ECE3400Team19/ECE3400Team19.github.io/index.md

# ECE 3400 Fall 2018 - Team 19

[Contract](Contract/contract.md)
||
[Lab 1](Lab1/lab1.md)
||
[Milestone 1](Milestone1/milestone1.md)
||
[Lab 2](Lab2/lab2.md)
||
[Milestone 2](Milestone2/milestone2.md)
||
[Lab 3](Lab3/lab3.md)
||
[Lab 4](Lab4/lab4.md)
||
[Milestone 3](Milestone3/milestone3.md)
||
[Milestone 4](Milestone4/milestone4.md)

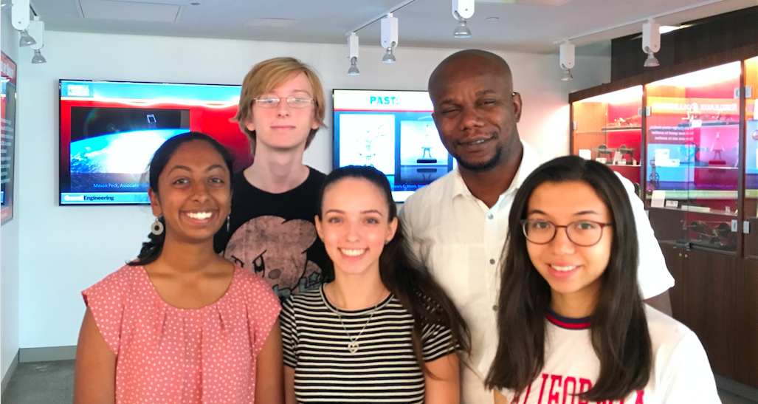
[picture p1: Team 19.png]
banner
## Team Members: 
* Asena Ulug          
* Cynthia Zelga
* John Chukwunonso Nwankwo
* Robert Morgowicz
* Laasya Renganathan
