ECE3400Team19/ECE3400Team19.github.io/Milestone4/milestone4.md

# Milestone 4: Treasure Detection
[Home](https://ece3400team19.github.io/)

## Milestone Description

Milestone 4 requires our robot to be able to:
  * detect when there are/are not treasures
  * successfully distinguish between red and blue treasures
  * successfully distinguish a square, triangle, and diamond shape

## Milestone Materials

This milestone was an extension of Lab 4 and utilized the same materials:
* OV7670 camera
* Altera DE0 Nano FPGA
* Arduino Uno

##
