ECE3400Team19/ECE3400Team19.github.io/6_Fotor.jpg

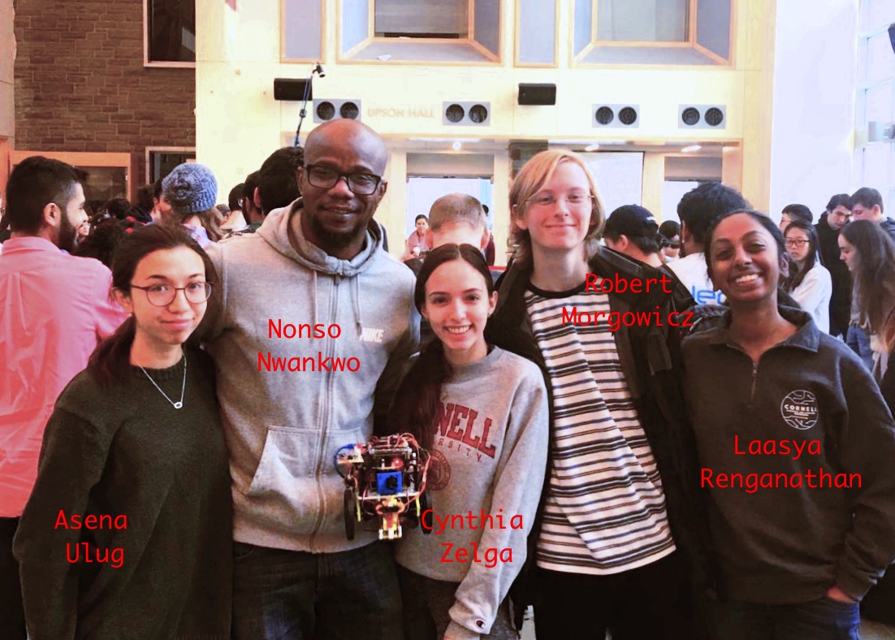
6_Fotor.jpg
