ECE3400Team19/ECE3400Team19.github.io/19-K.jpg

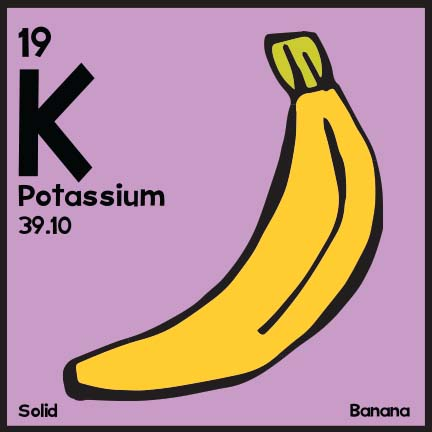
19-K.jpg
