ECE3400Team19/ECE3400Team19.github.io/arduino.JPG

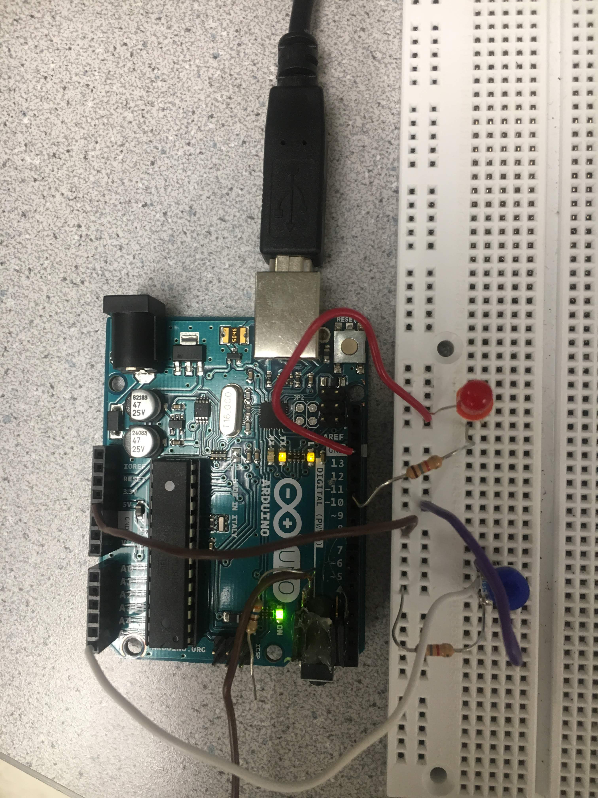
arduino.JPG
