ECE3400Team19/ECE3400Team19.github.io/Asena.png

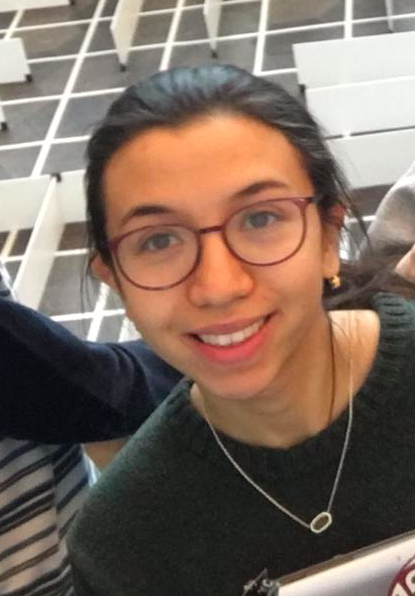
Asena.png
