ECE3400Team19/ECE3400Team19.github.io/camera-mount.jpg

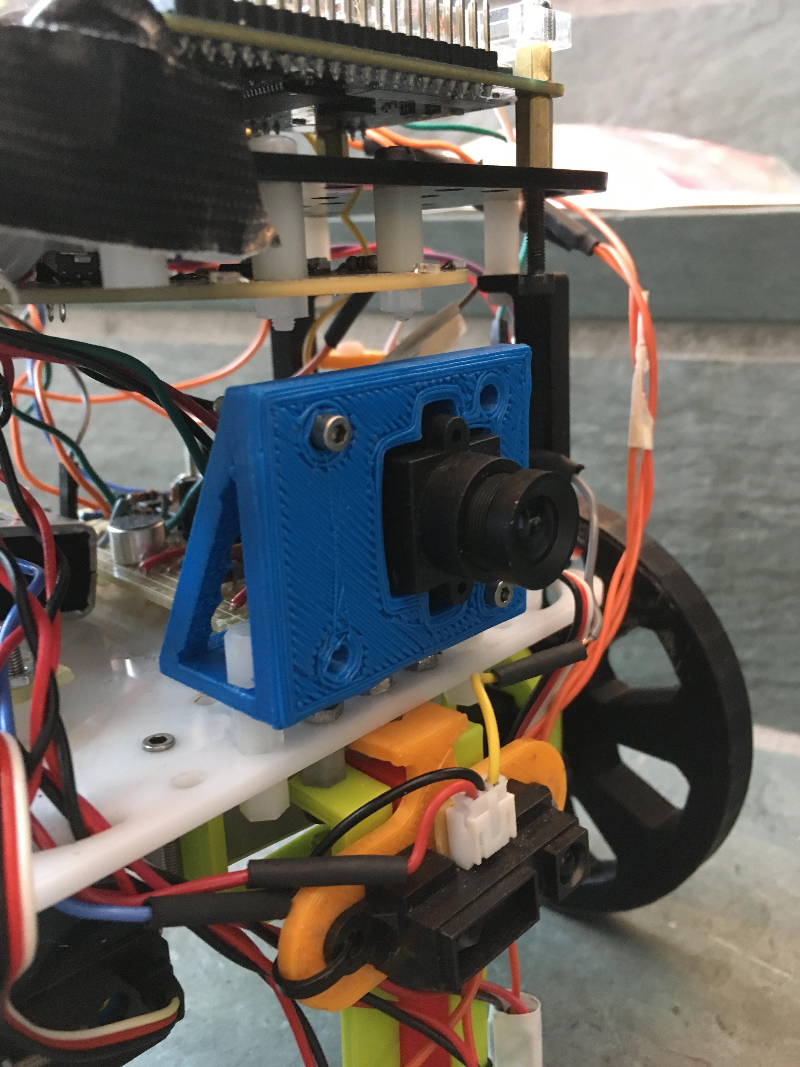
camera-mount.jpg
