ECE3400Team19/ECE3400Team19.github.io/Cynthia.png

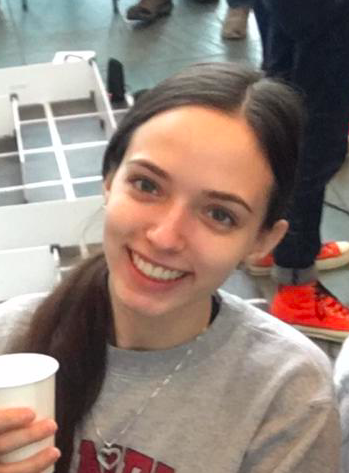
Cynthia.png
