ECE3400Team19/ECE3400Team19.github.io/Design.jpg

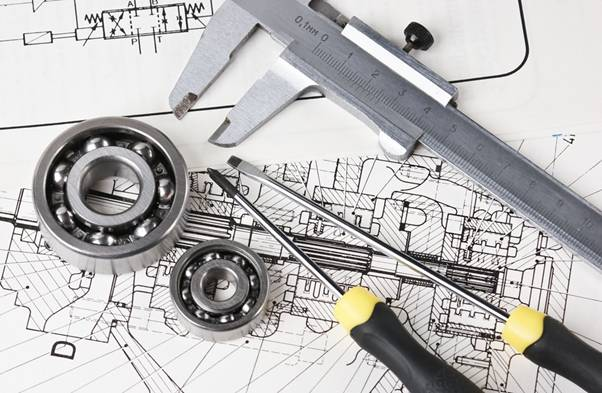
Design.jpg
