ECE3400Team19/ECE3400Team19.github.io/ethics.png

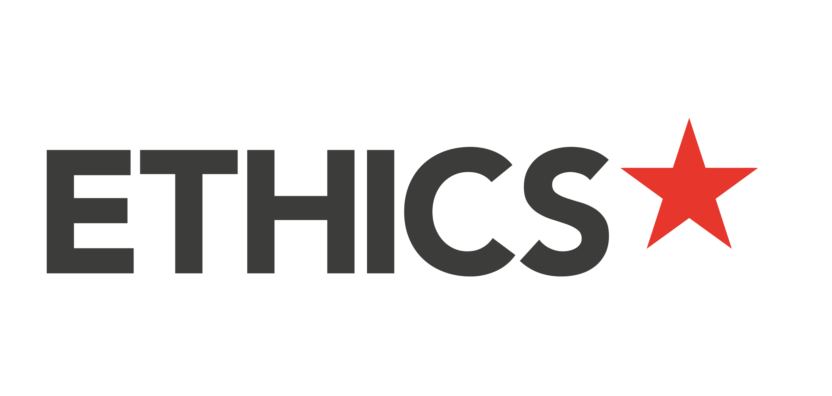
ethics.png
