ECE3400Team19/ECE3400Team19.github.io/Final_Des_FSM_Color.png

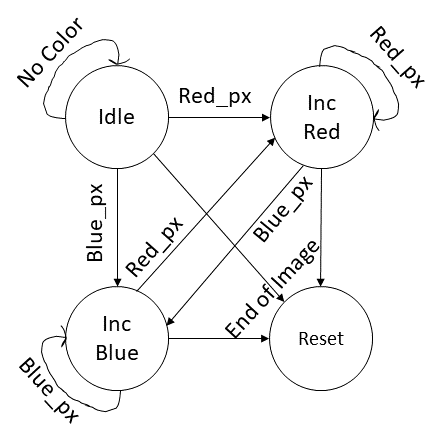
Final_Des_FSM_Color.png
