ECE3400Team19/ECE3400Team19.github.io/fpga-fun.jpg

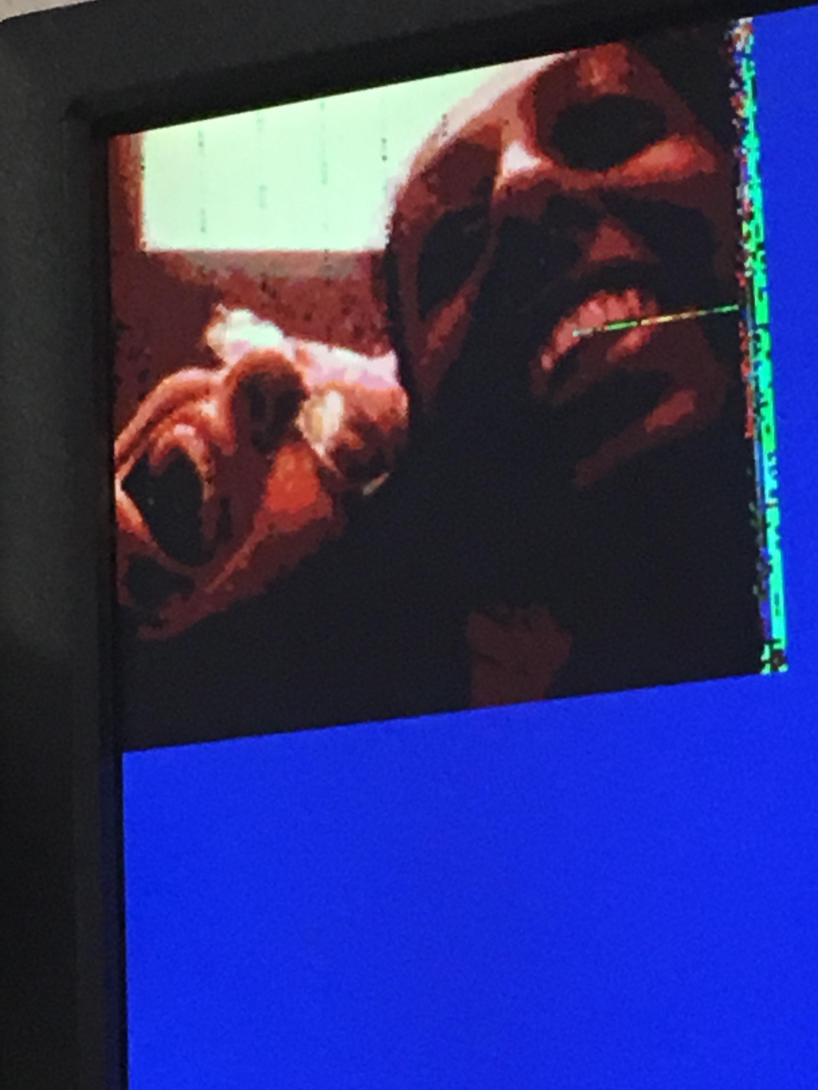
fpga-fun.jpg
