ECE3400Team19/ECE3400Team19.github.io/frobot.jpg

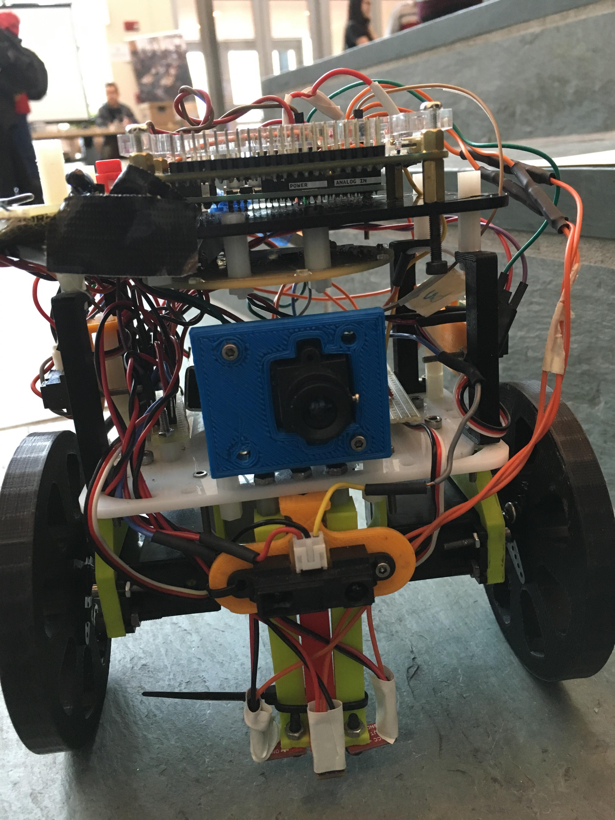
frobot.jpg
