ECE3400Team19/ECE3400Team19.github.io/IMG_8322.jpg

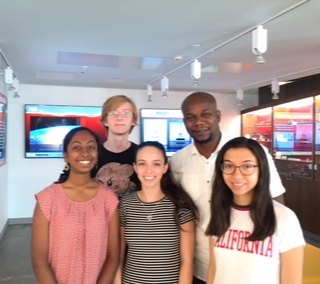
IMG_8322.jpg
