ECE3400Team19/ECE3400Team19.github.io/Laasya.png

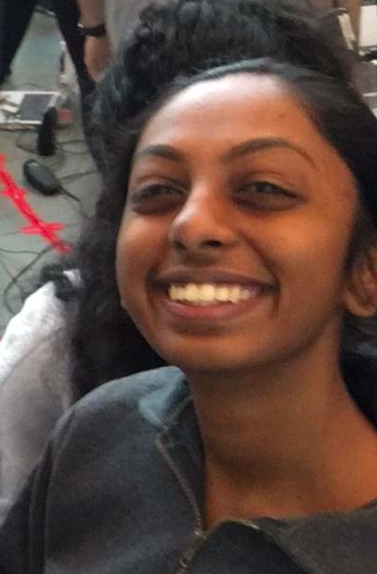
Laasya.png
