ECE3400Team19/ECE3400Team19.github.io/Lab4/Flag Code.jpeg

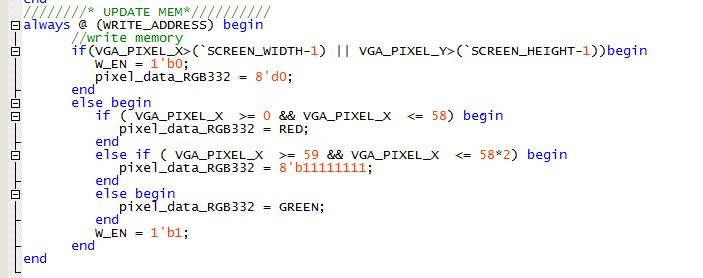
Lab4/Flag Code.jpeg
