ECE3400Team19/ECE3400Team19.github.io/more-snow.png

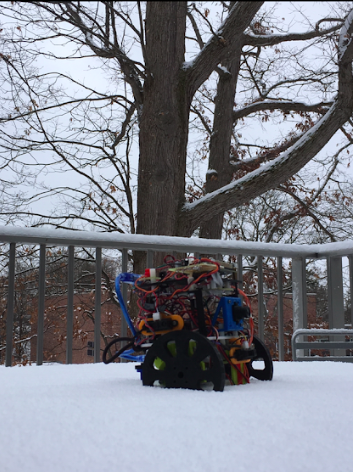
more-snow.png
