ECE3400Team19/ECE3400Team19.github.io/nonso.png

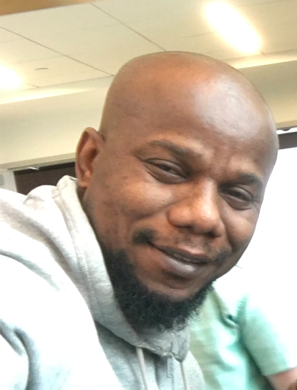
nonso.png
