ECE3400Team19/ECE3400Team19.github.io/Optical Circuit.JPG

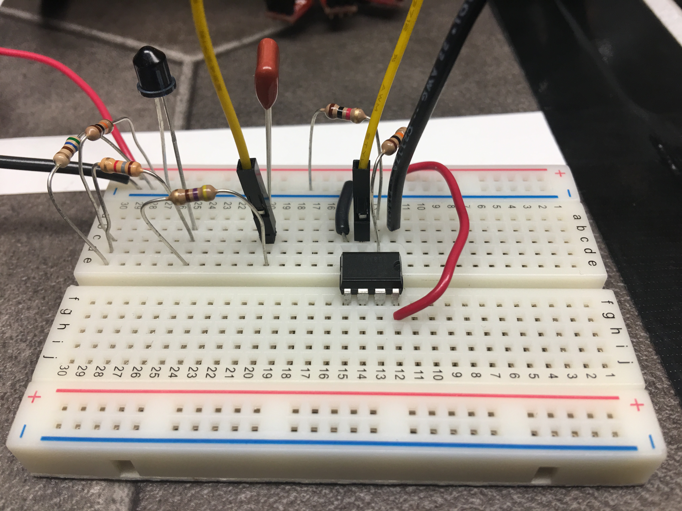
Optical Circuit.JPG
