ECE3400Team19/ECE3400Team19.github.io/Optical Reading 0.JPG

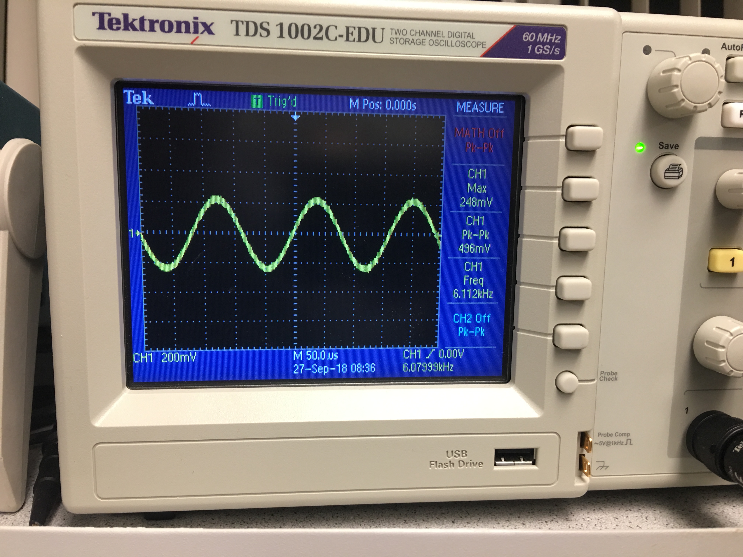
Optical Reading 0.JPG
