ECE3400Team19/ECE3400Team19.github.io/Optical Reading 1.JPG

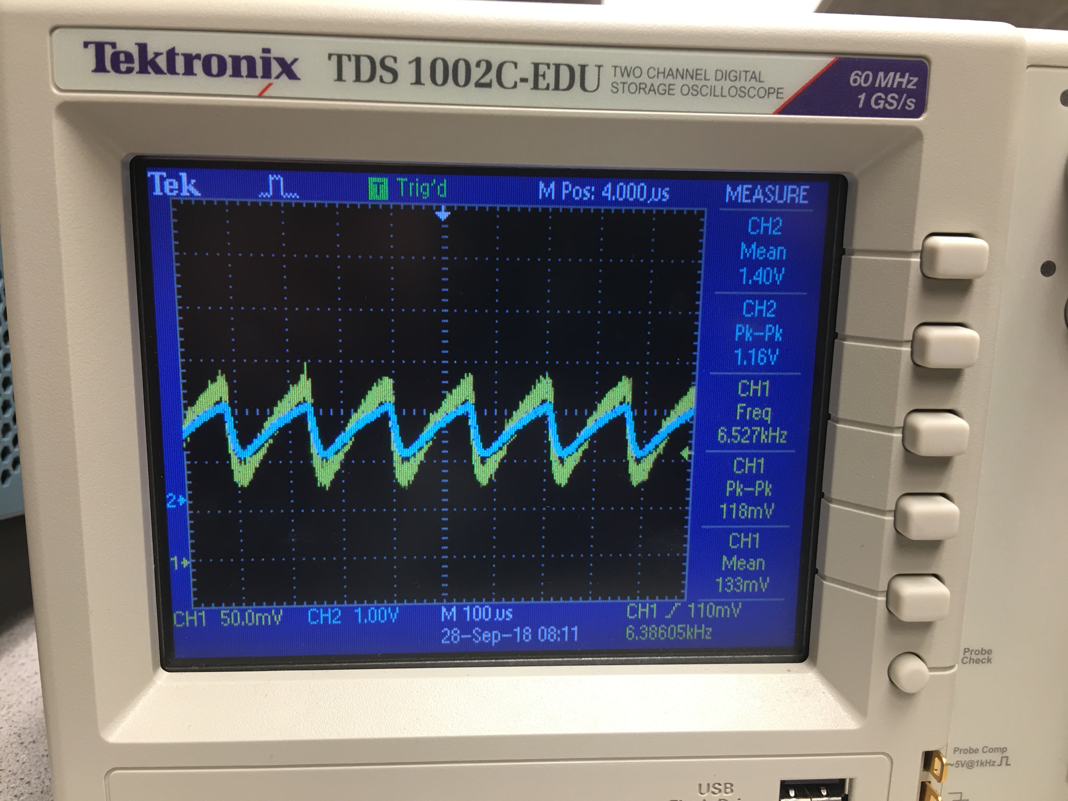
Optical Reading 1.JPG
