ECE3400Team19/ECE3400Team19.github.io/Optical Reading 2.JPG

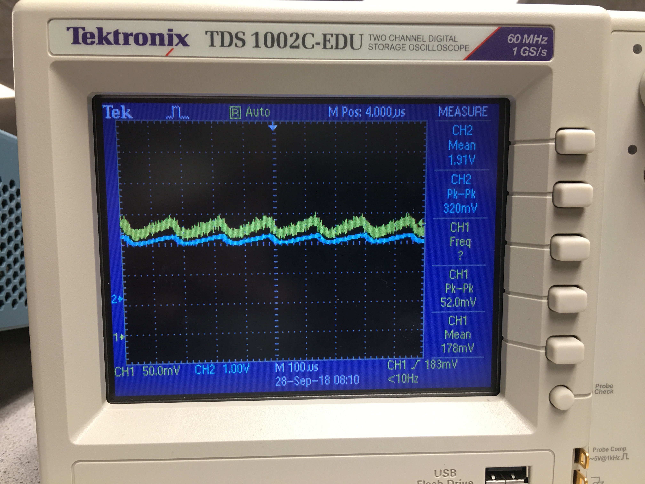
Optical Reading 2.JPG
