ECE3400Team19/ECE3400Team19.github.io/Optical_Bent_Photodetector.JPG

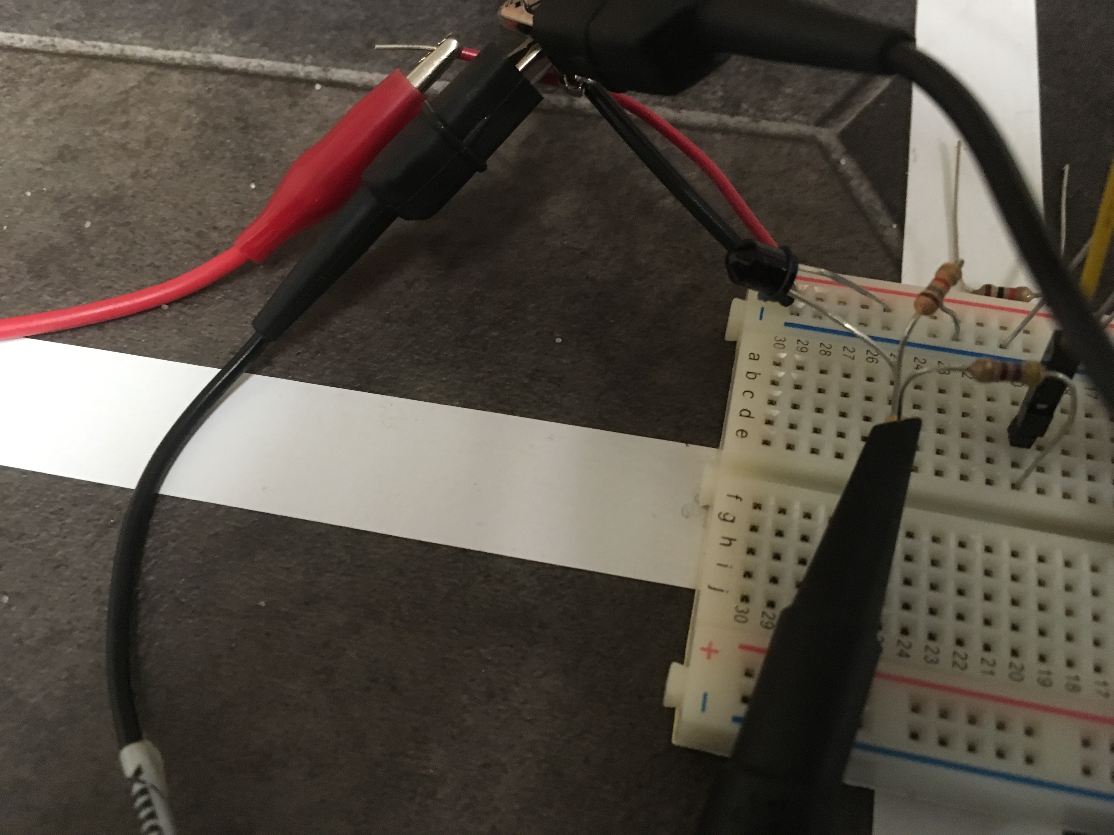
Optical_Bent_Photodetector.JPG
