ECE3400Team19/ECE3400Team19.github.io/Potassium.png

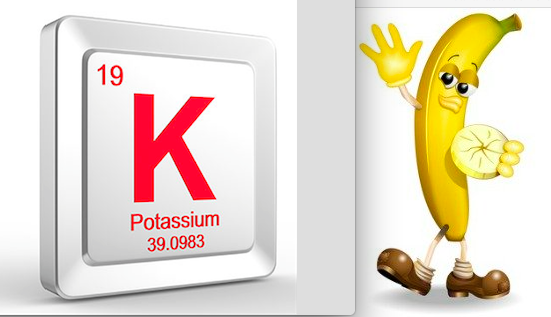
Potassium.png
