ECE3400Team19/ECE3400Team19.github.io/Robert.png

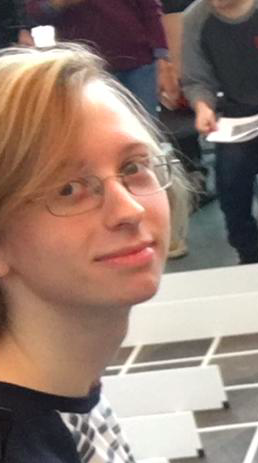
Robert.png
