ECE3400Team19/ECE3400Team19.github.io/Robot-k.jpeg

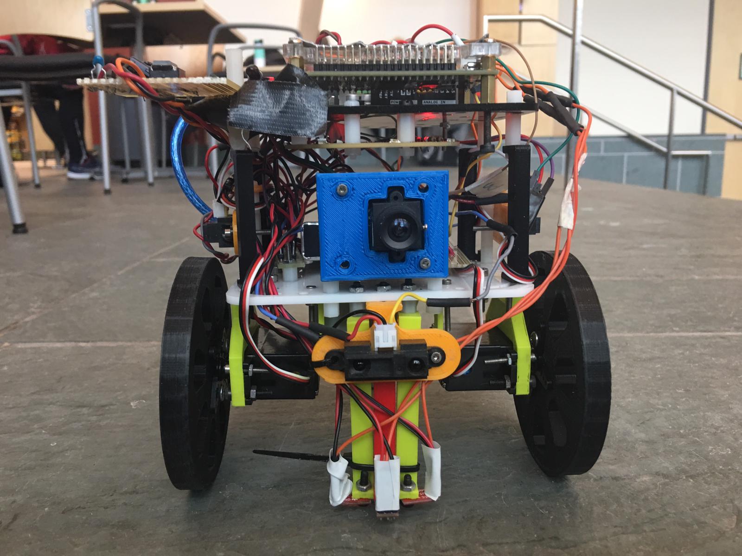
Robot-k.jpeg
