ECE3400Team19/ECE3400Team19.github.io/Robott.jpeg

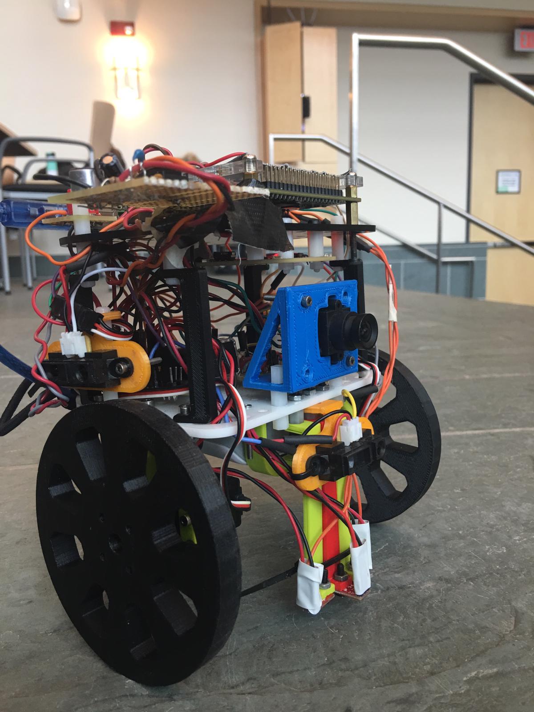
Robott.jpeg
