ECE3400Team19/ECE3400Team19.github.io/snow-profile.png

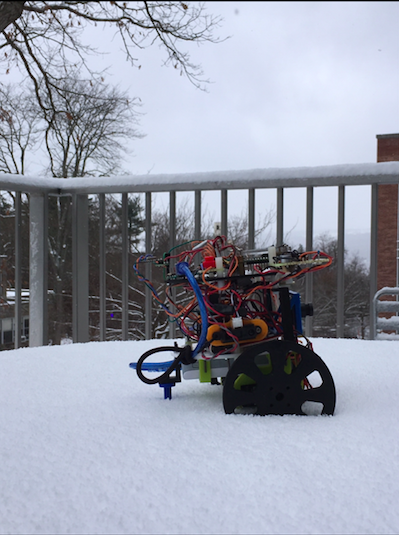
snow-profile.png
