ECE3400Team19/ECE3400Team19.github.io/snow_pic.JPG

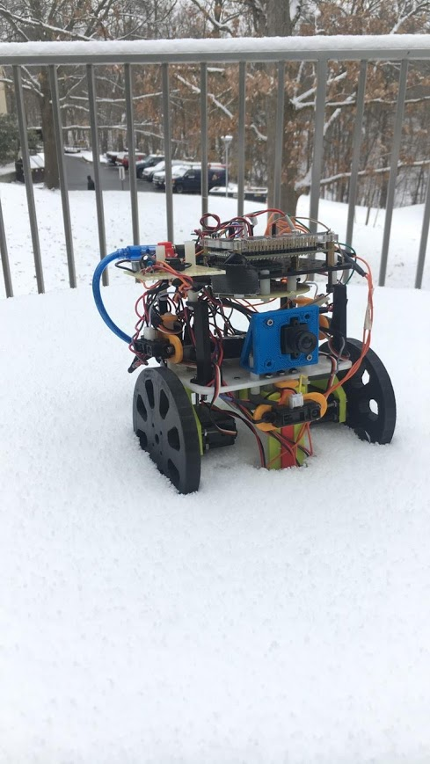
snow_pic.JPG
