ECE3400Team19/ECE3400Team19.github.io/snowbot.jpg

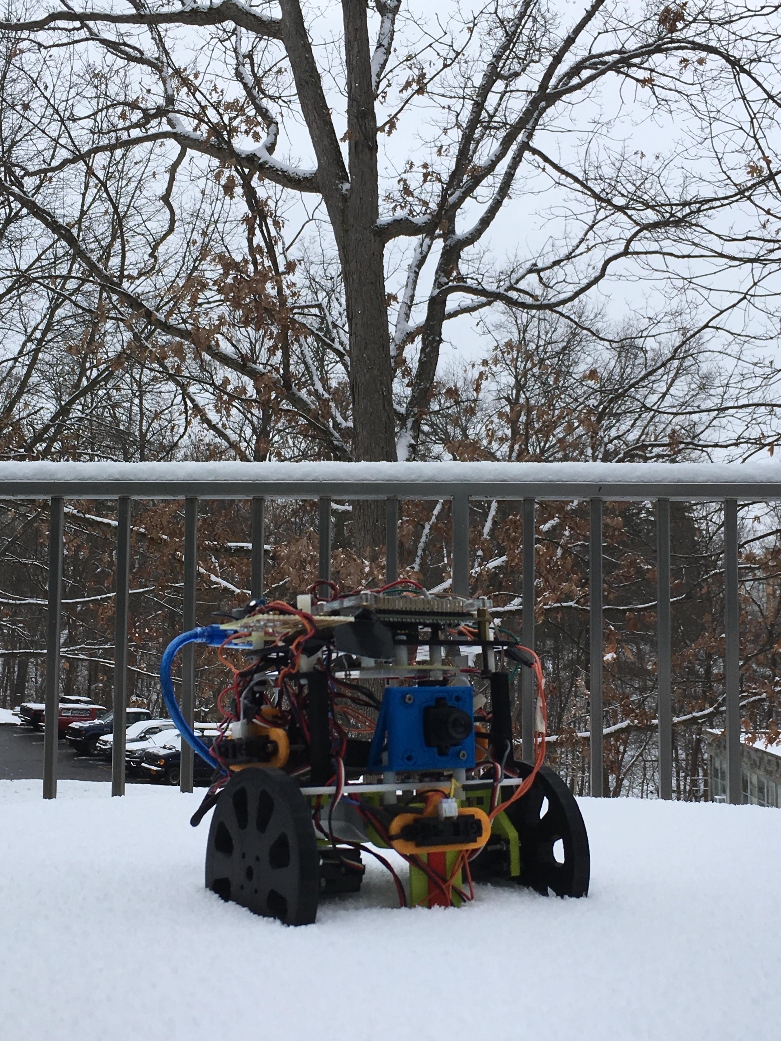
snowbot.jpg
