ECE3400Team19/ECE3400Team19.github.io/team-asena.jpg

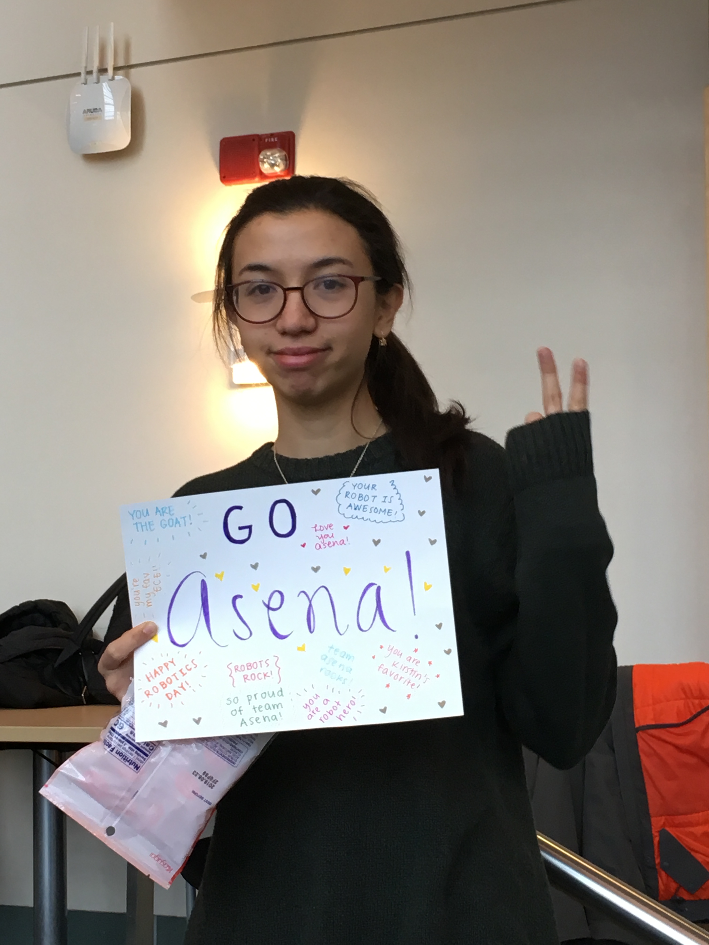
team-asena.jpg
