ECE3400Team19/ECE3400Team19.github.io/Lab4/Color_bar_test.png

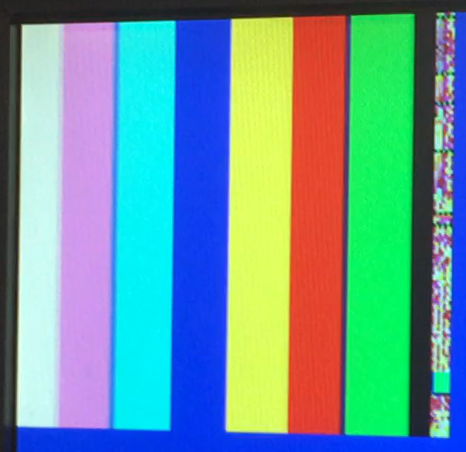
Lab4/Color_bar_test.png
