ECE3400Team19/ECE3400Team19.github.io/(commit log)

2018-09-06 Reordered videos for internal LED blinking
2018-09-06 Wrote up Part 2, external LED, to Lab 1
2018-09-07 Added Descriptions for Robot Assembly and Movement Demo
2018-09-07 writeup for pot controlled led
2018-09-07 added more to pot controlling led section
2018-09-07 code for servo part
2018-09-14 switched sensors to the front
2018-09-14 Inserted code for following a line
2018-09-26 added microphone circuit pic
2018-09-28 audio circuit oscilloscope pic
2018-09-28 Optical Circuit Writeup
2018-10-01 Lab 2 IR Schematic
2018-10-01 Uploaded IR circuit schematic
2018-10-01 Fixed the schematic sizing
2018-10-05 Lab 2 IR Schematic V2
2018-10-05 Updatedd Circuit Report
2018-10-05 updated code with LEDs
2018-10-12 wall sensor video
2018-10-14 code and video description for wall sensors
2018-10-15 talked about debugging LEDs
2018-10-21 code for starting on 660 Hz tone
2018-10-21 jcn 660Hz start
2018-10-25 prototype integration code
2018-11-02 Lab 4 writeup framework
2018-11-02 camera code :sparkles:
2018-11-02 camera setup shd work i think
2018-11-02 camera setup shd work :0
2018-11-26 camera comm w/ shape detect
2018-11-30 camera tests
2018-11-30 FPGA Code Uploaded
    [DE0_NANO.smp_dump.txt]
2018-12-02 i know this is wrong
    [Final3400.ino]
2018-12-02 :sob: :tired_face: :rage:
2018-12-03 current page's tab is now white
2018-12-06 fixed the home button
2018-12-06 Updated 3D printing section.
2018-12-06 making buttons smaller
2018-12-06 fixed fianl des FSM image
